mjdeiter/nanovna-console-enclosure/stl/NanoVNA_Console_v3_body_left.stl

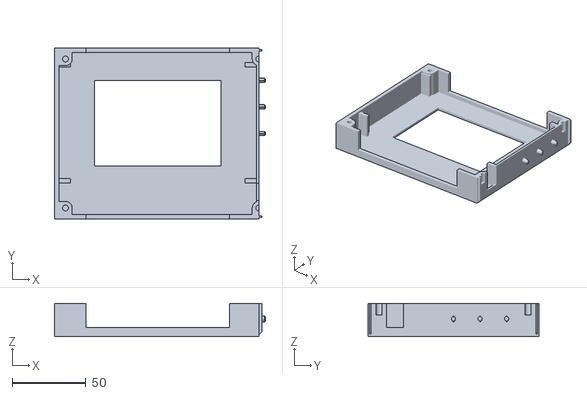
[picture p1: CAD file, 2026-11-13]
stl/NanoVNA_Console_v3_body_left.stl
143.0 x 116.0 x 22.5
