mjdeiter/nanovna-console-enclosure/stl/NanoVNA_Console_v3_body_right.stl

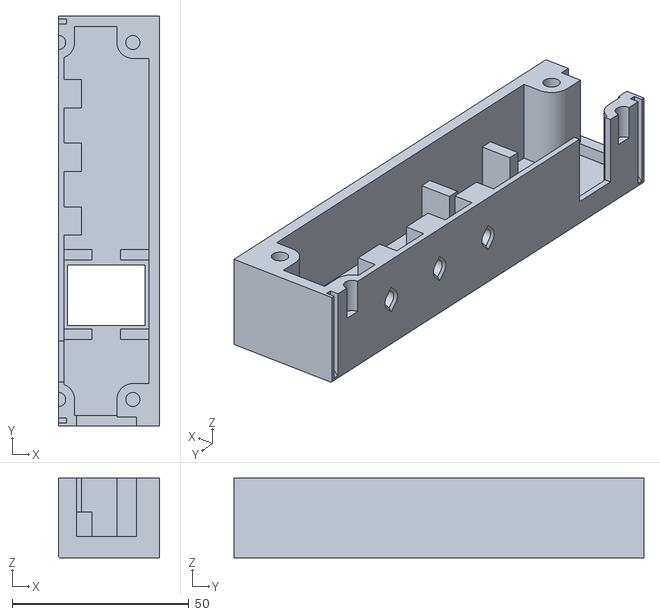
[picture p2: CAD file, 2026-11-13]
stl/NanoVNA_Console_v3_body_right.stl
28.5 x 116.0 x 22.5
