mjdeiter/nanovna-console-enclosure/stl/NanoVNA_Console_v3_back_plate.stl

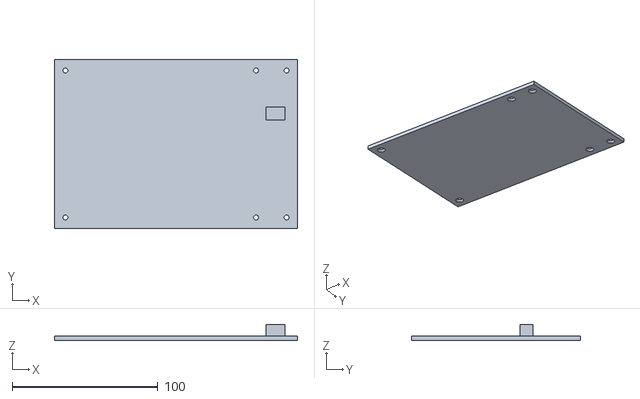
[picture p3: CAD file, 2026-11-13]
stl/NanoVNA_Console_v3_back_plate.stl
167.0 x 116.0 x 11.0
