mjdeiter/nanovna-console-enclosure/outdated/export(2).stl

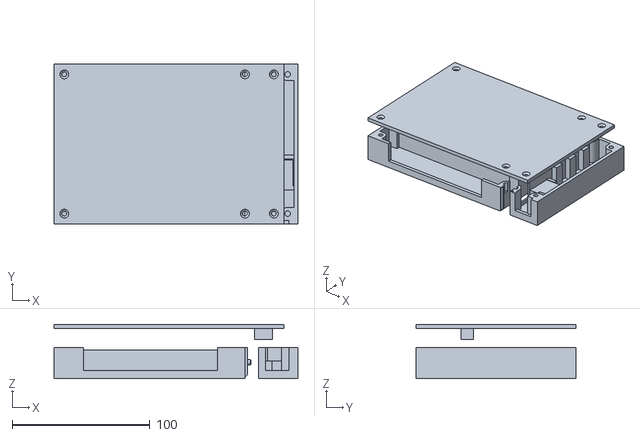
[picture p4: CAD file, 2026-11-13, an earlier design]
outdated/export(2).stl
177.0 x 116.0 x 39.5
