mjdeiter/nanovna-console-enclosure/(list of files, cad)

Other CAD files:
outdated/export.stl
openscad/Dual_NanoVNA_ESP32_Console_Enclosure_v3.scad
